lab11/audiBLE/README.md

# audiBLE
Bluetooth Low Energy audio sensing shield for squall
