lab11/audiBLE/hardware/rev_b/Audible Stairwell Data 2.xlsx

Sound | Integer Reading
Background Noise | 15-25 | Saturation | 2.275 V
Quiet Voice | 30-55 | (blowing on mic)
Normal Voice | 50-80
Loud Voice | 150-250
Walking Up Stairs | 100-150
Walking | 25-65
Clapping Hands | 90-160
