lab11/audiBLE/hardware/rev_b/Stairwell Volume Data.xlsx

Test Sound | Signal Integer Output
Background Noise | 55-75 | ~~120-150~~ | changed capacitor value I think
Quiet Voice | 120-160 | ~~160-210~~
Normal Voice | 150-300 | ~~220-470~~
Loud Voice | 300-550
Almost Yelling Voice | 600-700
Walking Up Stairs | 250-500 | ~~310-450~~
Light Walking | 80-90 | ~~160-190~~
Music Volume 30 | 110-120
Music Volume 20 | 85-100
