lab11/audiBLE/simulation/audible.asc

C1: cap; 100n
C6: cap; 1µ
C7: cap; 22µ
C8: cap; 0.1µ
M2: nmos; NMOS_SSM3K15AFS
R1: res; 1000
R2: res; 14k
R3: res; 1k
R6: res; 500
R14: res; 10k
R15: res; 10k
R16: res; 10k
R17: res; 20k
R18: res; 14k
R19: res; 1k
R20: res; 47k
U1: opamp2; MAX409B
U2: opamp2; MAX409B
U5: LTC1966
U6: opamp2; MAX409B
U7: opamp2; MAX409B
V1: voltage; 3.3
V2: voltage; SINE(0.65 0.003 500)
V3: voltage; ""; AC 0.000150
V4: voltage; SINE(0.65 0.003 500 0 0 0)
V5: voltage; 1.2
V6: voltage; PULSE(0 3.3 0.001 0 0 0.001 1 1)
V7: voltage; wavefile="talk.wav" chan=0
V8: voltage; 0.65
V9: voltage; SINE(0.65 0.003 500 0 0 0)
Named nets: 0, Vcc, Vref, GPIO, mic, sineref, AC, sineref2, RMS, OUT
.tran 1s
* ////////////// MAX409B MACROMODEL //////////////////
*
*  ===>  MAX409B MUST BE OPERATED WITH CLOSED-LOOP
*        GAIN OF 10V/V OR GREATER TO INSURE STABILITY  <====
*
* connections:        non-inverting input
*                     |   inverting input
*                     |   |   positive power-supply
*                     |   |   |   negative power-supply
*                     |   |   |   |   output
*                     |   |   |   |   |
* OUTPUT CONNECTS:    1   2   99  50  97
*
.SUBCKT MAX409B 1 2 99 50 97
****************INPUT STAGE**********************
I1 99 4 20U
M1   5  2 4 99 MOSFET
R3   5 50 5.2696K
M2   6  7 4 99 MOSFET
R4   6 50 5.2696K
CI1  1  0 2P
CI2  2  0 2P
DP1  1 99 DA
DP2 50  1 DX
DP3  2 99 DX
DP4 50  2 DB
C4  5 6 .07N
*POLE AT 25KHZ
************ GSUP CREATES AVOL VS VSUPPLY ********
EH 99 98 99 50 0.5
GSUP 0 106 POLY(1) 99 50 320 -41 1.2
*THIS POLY VCCS MODELS THE OPEN LOOP GAIN AS
*A FUNCTION OF THE POWER SUPPLY, WHICH WILL BE MULT. NODE 5,6 VOLT.
RVSUP 0 106 1E4
************ GAIN, 1ST POLE, SLEW STAGE************
G0 98 9 POLY(2) 5 6 106 0 0 0 0 0 1E-6
*GO MULTIPLIES NODE 106, AVOL VS SUPPLY, AND NODES 5,6 FROM INPUT STAGE.
VS 9 10 0V
R0  98  9 1E6
C3 10 98 1.3UF
D1 9 111 DX
D2 112 9 DX
V11 99 111 .5V
V12 112 50 .5V
I2 99 50 -19U
EOS 7 1 POLY(1) 16 98 .75E-3 1
*********COMMON-MODE ZERO STAGE********
G4 98 16 POLY(2) 1 98 2 98 0 1E-7 1E-7
R13 98 16 500
******* POLE AND STAGE **********
G3 98 15 10 98 1E-3
R12 98 15 1E3
C5 98 15 1.77N
*            POLE AT 30KH
******** POLE / ZERO STAGE ******
G5 98 18 15 98 1E-3
R14 98 18 1K
C6 18 19 4.42NF
R19 19 98 800
*************OUTPUT STAGE****************
F5 99 38 VA8 1
D9 40 38 DX
D10 38 99 DX
VA7 99 40 0
G12 98 32 18 98 1E-6
*          ^ INSERT NODE FROM LAST STAGE HERE
R15 98 32 1E6
D3 32 36 DX
D4 37 32 DX
V5 35 37 .2V
V4 36 35 -.2V
*V5,V4 SET ISC
R16 34 35 1K
E1 99 33 99 32 1
VA8 33 34 0V
L 35 97 0.5
RCON 35 97 30K
*RCON ALSO  ENHANCES CONVERGENCE FEATURES
******************************************
.MODEL DA D(IS=100E-14 RS=0.5K)
.MODEL DB D(IS=100E-14 RS=0.5K)
.MODEL DX D(IS=100E-14)
.MODEL MOSFET PMOS(VTO=-1.7 KP=1.8E-3)
*VTO ESTABLISHES INPUT VOLT. RANGE
.ENDS
*********************************************************************
*  TOSHIBA CORPORATION SEMICONDUCTOR & STORAGE PRODUCTS COMPANY
*  Date                 : 15/12/2014
*  File name            : SSM3K15AFS.lib
*  Part Number          : SSM3K15AFS
*  Parameter ver.       : Ver.1
*  Simulator            : PSPICE
*  Model call name      : NMOS_SSM3K15AFS
*  TNOM                 : 25 degree
*********************************************************************
 
.SUBCKT NMOS_SSM3K15AFS 1 2 3
M0 1 22 3 3
+ smsmosfet
+ L = 5E-006
+ W = 0.008
+ AD = 8e-09
+ AS = 8e-09
+ PD = 0.016
+ PS = 0.016
D0 3 1
+ DDS1
D1 3 1
+ DDS2
D2 2 10
+ DGS1
D3 3 10
+ DGS2
R1 10 3 1E+009
R2 10 2 1E+009
RG 2 22 200
.MODEL smsmosfet NMOS
+ LEVEL = 7
+ MOBMOD = 1
+ CAPMOD = 3
+ NOIMOD = 1
+ TOX = 1.5E-008
+ XJ = 1.5E-007
+ NCH = 1.7E+017
+ NGATE = 0
+ RSH = 0
+ TNOM = 25
+ VTH0 = 1.2076
+ VOFF = -0.02
+ NFACTOR = 3.583
+ U0 = 952.2693
+ K1 = 0.5
+ K2 = 0
+ K3 = 80
+ K3B = 0
+ W0 = 2.5E-006
+ NLX = 1.74E-007
+ DVT0 = 2.2
+ DVT1 = 0.53
+ DVT2 = -0.032
+ DVT0W = 0
+ DVT1W = 5.3E+006
+ DVT2W = -0.032
+ DWG = 0
+ DWB = 0
+ UA = 4.436e-13
+ UB = 5.87E-019
+ UC = -4.65E-011
+ VSAT = 112118.3748
+ A0 = 1.2732
+ AGS = 0.029771
+ B0 = 0
+ B1 = 0
+ KETA = -0.047
+ A1 = 0
+ A2 = 1
+ DELTA = 0.02079
+ RDSW = 8680
+ PRWG = 0
+ PRWB = 0
+ WR = 1
+ CDSC = 0.00024
+ CDSCD = 0
+ CDSCB = 0
+ CIT = 0
+ ETA0 = 0.08
+ ETAB = -0.07
+ DSUB = 0.56
+ PCLM = 0.0014469
+ PDIBLC1 = 0.39
+ PDIBLC2 = 0.012118
+ PDIBLCB = 0
+ DROUT = 0.56
+ PSCBE1 = 4.24E+008
+ PSCBE2 = 1E-009
+ PVAG = 0
+ ALPHA0 = 0
+ ALPHA1 = 0
+ BETA0 = 30
+ NJ = 1
+ JS = 1.6481e-14
+ XPART = 0
+ CGSO = 1.9718e-10
+ CGDO = 3.5042e-10
+ CGBO = 0
+ CGDL = 1.5468e-08
+ CGSL = 2.4386e-12
+ CKAPPA = 2.9066
+ CF = 0
+ CLC = 1E-007
+ CLE = 0.6
+ VOFFCV = 0
+ NOFF = 1
+ DLC = 0
+ ACDE = 1
+ MOIN = 15
+ CJ = 3.2319e-06
+ CJSW = 1E-012
+ CJSWG = 1E-012
+ PB = 0.40048
+ PBSW = 1
+ PBSWG = 1
+ MJ = 1.7065
+ MJSW = 0.33
+ MJSWG = 0.33
+ AF = 1
+ EF = 1
+ KF = 0
+ UTE = -0.5
+ KT1 = -0.665
+ KT1L = 0
+ KT2 = 0.022
+ UA1 = 4.31E-009
+ UB1 = -7.61E-018
+ UC1 = -5.6E-011
+ AT = 3300
+ PRT = 15000
+ XTI = 3
+ TCJ = 0
+ TPB = 0
+ TCJSW = 0
+ TPBSW = 0
+ TCJSWG = 0
+ TPBSWG = 0
+ DWC = 0.0035277
.MODEL DDS1 D
+ TNOM = 25
+ IS = 8.8013e-14
+ RS = 1.1503
+ N = 1.15
+ CJO = 1.5691e-15
+ VJ = 0.85666
+ M = 0.54386
+ XTI = 3
+ BV = 30
+ IBV = 0.0001
.MODEL DDS2 D
+ TNOM = 25
+ IS = 8.8013e-14
+ RS = 1.1503
+ N = 1.15
+ CJO = 2.9872e-12
+ VJ = 0.69573
+ M = 0.36689
+ XTI = 3
.MODEL DGS1 D
+ TNOM = 25
+ IS = 1E-015
.MODEL DGS2 D
+ TNOM = 25
+ IS = 1E-015
.ENDS
