lab11/audiBLE/hardware/rev_b/audiBLE_revB.brd

## EAGLE design hardware/rev_b/audiBLE_revB.brd (2017-04-20)

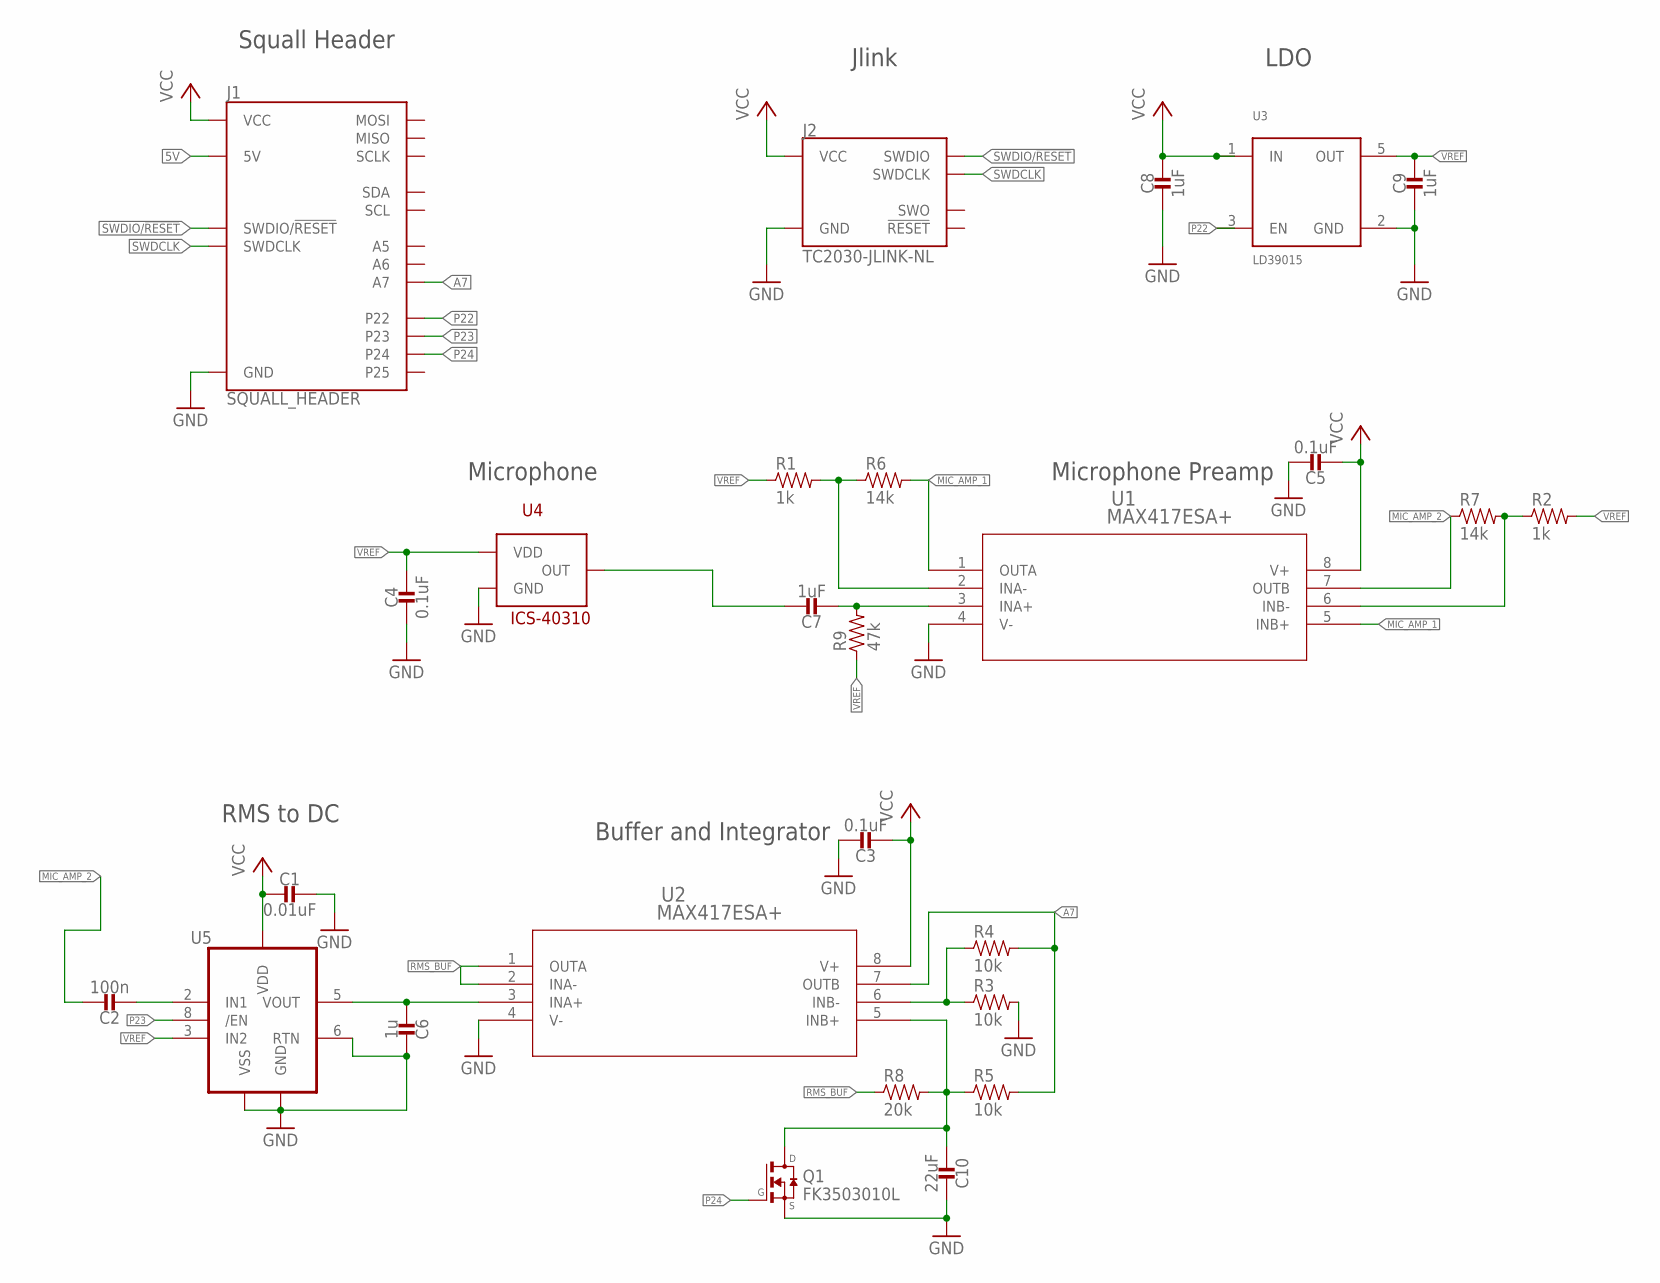
[picture p1: schematic audiBLE_revB.sch]

Parts:
C1: 0.01uF; 0402_CAP
C2: 100n; 0402_CAP
C3, C4, C5: 0.1uF; 0402_CAP
C6: 1u; 0402_CAP
C7, C8, C9: 1uF; 0402_CAP
C10: 22uF; 0402_CAP
J1: SQUALL_HEADER
J2: TC2030-JLINK-NL; TC2030-IDC-NL
Q1: FK3503010L; SC85
R1, R2: 1k; 0402_RES
R3, R4, R5: 10k; 0402_RES
R6, R7: 14k; 0402_RES
R8: 20k; 0402_RES
R9: 47k; 0402_RES
U1, U2: MAX417ESA+; 21-0041B_8
U3: LD39015; SOT-23-5
U4: ICS-40310; LGA_CAV3
U5: LTC1966CMS8; MSOP8

Connections:
5V: J1.A5 (5V), J1.A7 (5V)
A7: J1.B5 (A7), R4.2, R5.2, U2.7 (OUTB)
GND: C1.1, C3.1, C4.2, C5.1, C6.1, C8.2, C9.2, C10.1, J1.A9 (GND), J1.A10 (GND), J2.5 (GND), Q1.2 (S), R3.2, U1.4 (V-), U2.4 (V-), U3.2 (GND), U4.P$2 (GND), U5.1 (GND), U5.4 (VSS), U5.6 (RTN)
MIC: C7.1, U4.P$1 (OUT)
MIC_AMP_1: R6.2, U1.1 (OUTA), U1.5 (INB+)
MIC_AMP_2: C2.1, R7.1, U1.7 (OUTB)
unnamed: C7.2, R9.2, U1.3 (INA+)
unnamed: C2.2, U5.2 (IN1)
unnamed: C6.2, U2.3 (INA+), U5.5 (VOUT)
unnamed: R1.2, R6.1, U1.2 (INA-)
unnamed: R2.1, R7.2, U1.6 (INB-)
unnamed: R3.1, R4.1, U2.6 (INB-)
unnamed: C10.2, Q1.3 (D), R5.1, R8.2, U2.5 (INB+)
P22: J1.A2 (P22), U3.3 (EN)
P23: J1.A4 (P23), U5.8 (/EN)
P24: J1.A6 (P24), Q1.1 (G)
RMS_BUF: R8.1, U2.1 (OUTA), U2.2 (INA-)
SWDCLK: J1.B2 (SWDCLK), J2.4 (SWDCLK)
SWDIO/!RESET: J1.B4 (SWDIO/!RESET), J2.2 (SWDIO)
VCC: C1.2, C3.2, C5.2, C8.1, J1.A1 (VCC), J1.A3 (VCC), J2.1 (VCC), U1.8 (V+), U2.8 (V+), U3.1 (IN), U5.7 (VDD)
VREF: C4.1, C9.1, R1.1, R2.2, R9.1, U3.5 (OUT), U4.P$3 (VDD), U5.3 (IN2)

Notes on the sheet:
Squall Header
Microphone
Microphone Preamp
Jlink
LDO
RMS to DC
Buffer and Integrator

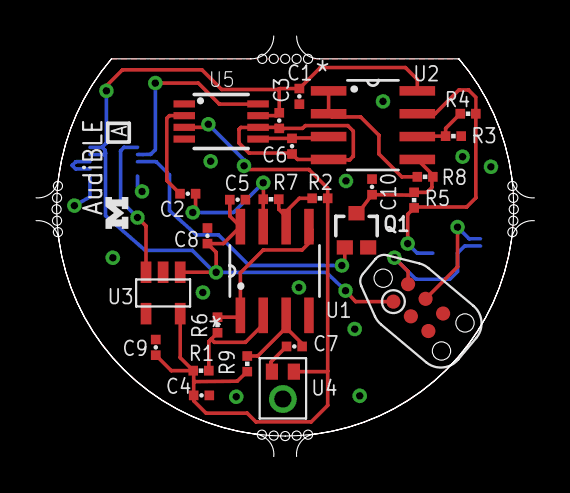
[picture p2: board audiBLE_revB.brd from above]

Board: 2 copper layers, 27.7 x 23.4 mm, 28 parts (0 on the bottom side), 21 nets.

Other parts of the board:
U$1: UMICH_SOLID_50MIL
