lab11/audiBLE/(threads)

Thread 1 (2016-08-19):

Real world integrator does not work like simulation

amitshah326, 2016-08-19:
The integrator on rev A does not reset properly. Instead of pulling the output to ground, it pulls it to 1V. The possible reasons for this could be the integrator's gain is 4.54V/V which is less than the 10V/V necessary for the OP amp to be stable or the capacitive load is too high. The next course of action would be to replace the OP amp with one that is stable at this gain and can work with this capacitive load. An alternative route would be to create another integrator topology.
