lab11/audiBLE/(commit log)

2016-08-04 added mic sample
2016-08-08 Starting eagle schematic
    [audible.sch]
2016-08-09 ripped up blees board
    [audible.brd, audible.sch]
2016-08-09 Upped Vref to 1.2V
2016-08-09 Almost completed schematic
    [audible.brd, audible.sch]
2016-08-09 better layout
    [audible.brd, audible.sch]
2016-08-09 better schematic
    [audible.brd, audible.sch]
2016-08-09 Updated sch and brd
    [audible.brd, audible.sch]
2016-08-10 almost routed
    [audible.brd, audible.sch]
2016-08-10 fixed clearance issues from wrong wire width
    [audible.brd]
2016-08-10 Removed headers and fixed wire angles
    [audible.brd, audible.sch]
2016-08-10 Cleaned up routes all over
    [audible.brd]
2016-08-10 Fixed ref names
    [audible.brd, audible.sch]
2016-08-11 Added BOM and copied over panel files from blees
    [audible.brd, audible.sch, audible_bom.xlsx, merge.cfg]
2016-08-11 updted BOM
    [audible_bom.xlsx]
2016-08-11 Updated Part Names and digikey part names
    [audible.brd, audible.sch, audible_bom.xlsx]
2016-08-11 added files for eagle.py
    [merge.cfg, revC_frame.brd]
2016-08-11 removed gerbers
2016-08-11 aded BOM files
    [audible_bom.csv]
2016-08-11 added panel gerbers
2016-08-15 added ADC
2017-04-20 Added rev_b schematic and board files to reflect changes in connections on R4
    [audiBLE_revB.brd, audiBLE_revB.sch, audible_bom.csv, audible_bom.xlsx]
2017-05-31 Added summary of work and stairwell data
    Added a formal summary of the work that I completed on AudiBLE
    Added two spreadsheets of the audio data I collected while experimenting in the BBB stairwell
    [Audible Stairwell Data 2.xlsx, Stairwell Volume Data.xlsx]
